eSpark-Backup/zion-holmes-portable-charger/Deliverables/Portable Charger v1.0/Renderings/2D_Top_View.PNG

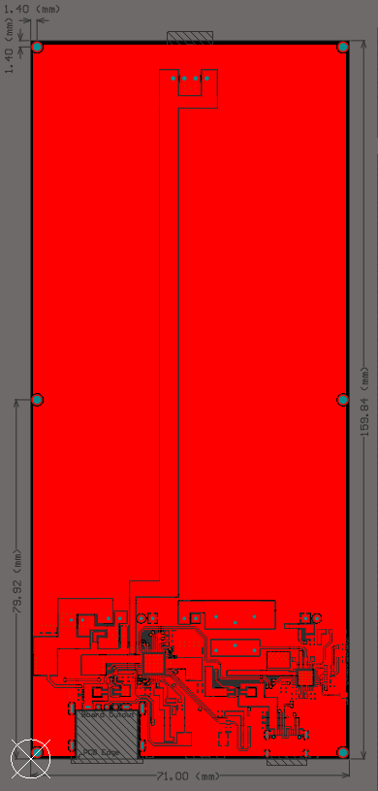
Deliverables/Portable Charger v1.0/Renderings/2D_Top_View.PNG
