eSpark-Backup/zion-holmes-portable-charger/Deliverables/Portable Charger v1.0/Renderings/3D_Bottom_View.PNG

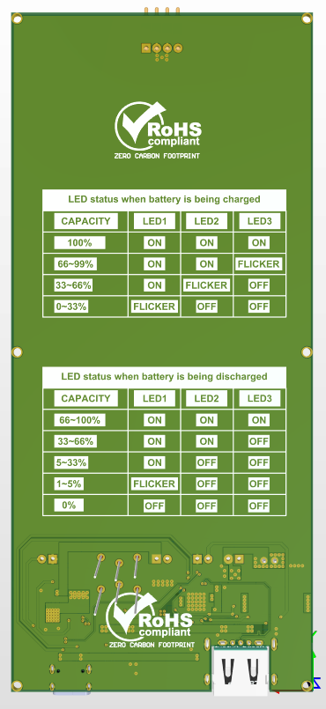
Deliverables/Portable Charger v1.0/Renderings/3D_Bottom_View.PNG
