eSpark-Backup/zion-holmes-portable-charger/Deliverables/Portable Charger v1.0/Renderings/3D_Isometric_View.png

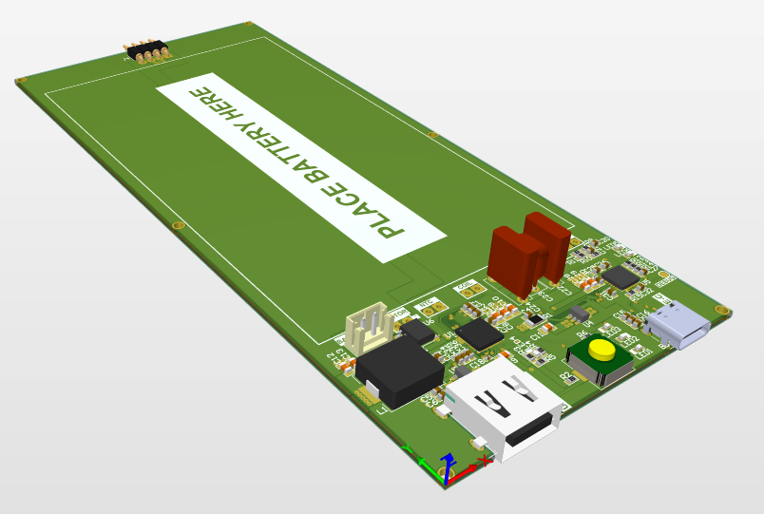
Deliverables/Portable Charger v1.0/Renderings/3D_Isometric_View.png
