eSpark-Backup/zion-holmes-portable-charger/Deliverables/Portable Charger v1.0/Supporting Files/Portable-Charger-v1.0_3D.step

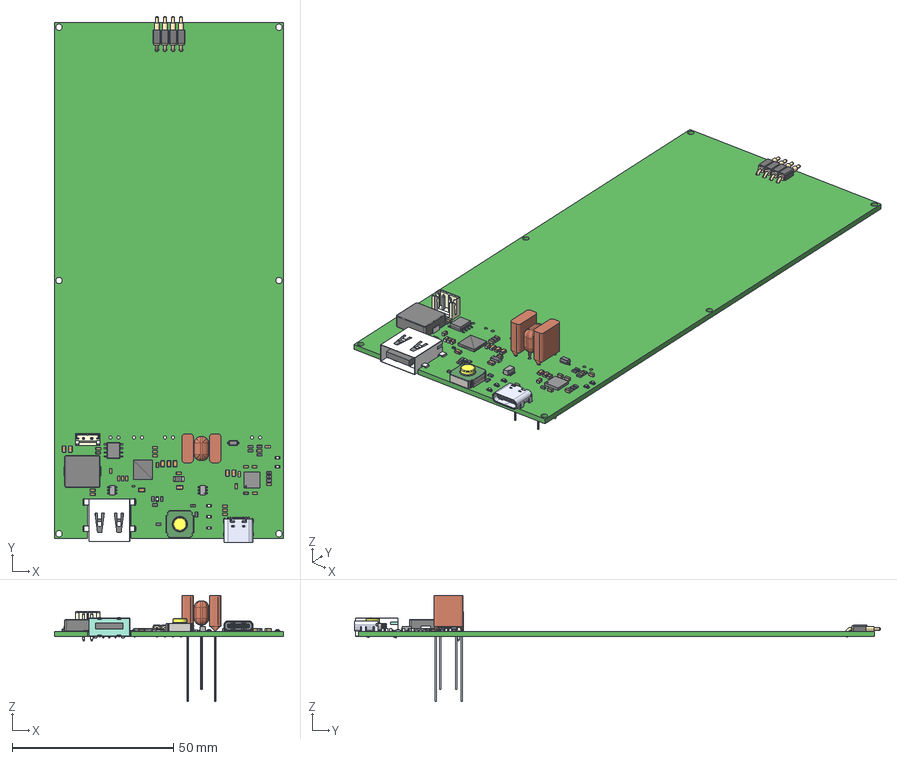
[picture p7: CAD file, 2023-05-12]
Deliverables/Portable Charger v1.0/Supporting Files/Portable-Charger-v1.0_3D.step
71.0 x 163.2 x 33.0 mm
User_Library-CAPC1608X09 x 23
AP64501SP-13
User_Library-RESC1608X05N x 15
User_Library-QFN-32-5x5_-_EQ
21-0058I_MXM x 2
U224-051N-3GRA035
QFN-48
skstace010
User_Library-CR3216-1206
User_Library-LED_SMD0603 x 6
yspi1040-2r2m
Pogo_Spring_4_Pin
TYPE-C-31-M-12
User_Library-B2B-EH-A
1N5819HW-7-F--3DModel-STEP-56544
User_Library-0805_SMD_Capacitor x 9
MPP254J100V82CB0035 x 2
PE154J2A0502
User_Library-Capacitor_0402
