eSpark-Backup/zion-holmes-portable-charger/Deliverables/Portable Charger v1.0/Supporting Files/Portable-Charger-v1.0.DXF

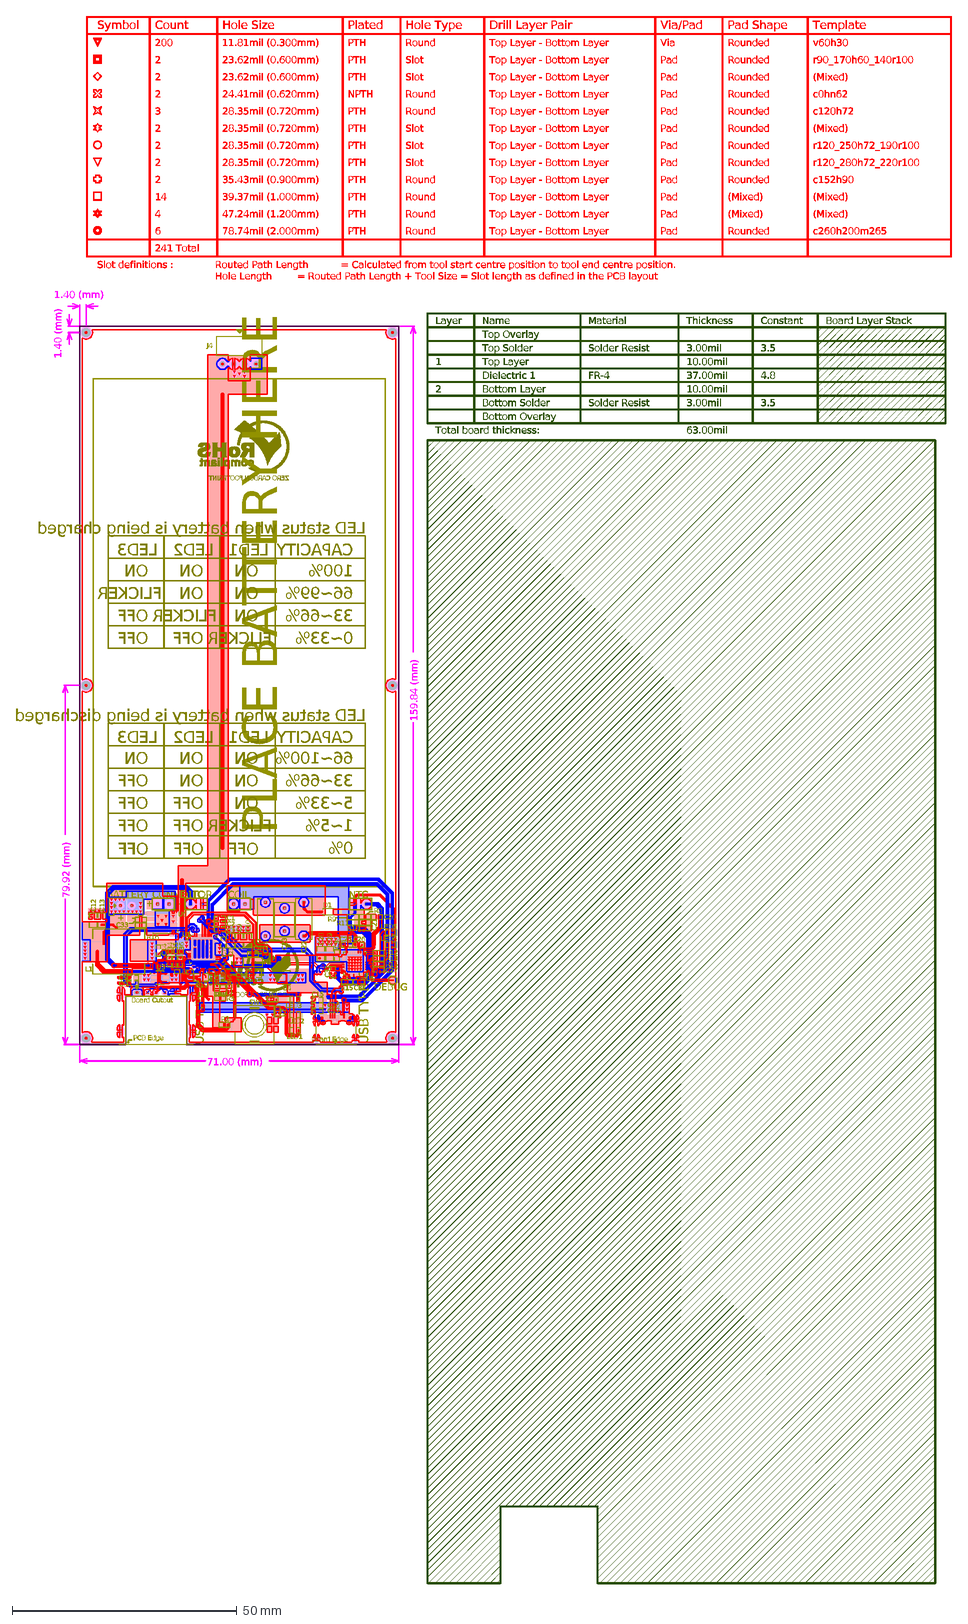
[picture p8: CAD file, 2023-05-12]
Deliverables/Portable Charger v1.0/Supporting Files/Portable-Charger-v1.0.DXF
-
+
USB TYPE-C
DEBUG
PLACE BATTERY HERE
NTC
COIL
USB TYPE-A
BATTERY CONNECTOR
Template
v60h30
r90_170h60_140r100
(Mixed)
c0hn62
c120h72
r120_250h72_190r100
r120_280h72_220r100
c152h90
c260h200m265
Pad Shape
Rounded
Via/Pad
Via
Pad
Drill Layer Pair
Top Layer - Bottom Layer
Hole Type
Round
Slot
Plated
PTH
NPTH
Hole Size
11.81mil (0.300mm)
23.62mil (0.600mm)
24.41mil (0.620mm)
28.35mil (0.720mm)
35.43mil (0.900mm)
39.37mil (1.000mm)
47.24mil (1.200mm)
78.74mil (2.000mm)
Count
241 Total
200
2
3
14
4
6
Symbol
= Routed Path Length + Tool Size = Slot length as defined in the PCB layout
Hole Length
= Calculated from tool start centre position to tool end centre position.
Routed Path Length
Slot definitions :
FLICKER
CAPACITY
ON
ZERO CARBON FOOTPRINT
OFF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
