eSpark-Backup/zion-holmes-portable-charger/(list of files, cad)

Other CAD files:
Design Files/Portable-Charger-v1.0/Portable-Charger-v1.0.step
Deliverables/Portable Charger v1.0/Supporting Files/Portable-Charger-v1.0.DWG
