eSpark-Backup/zion-holmes-portable-charger/Deliverables/Portable Charger v1.0/Schematics/Portable-Charger-v1.0.pdf

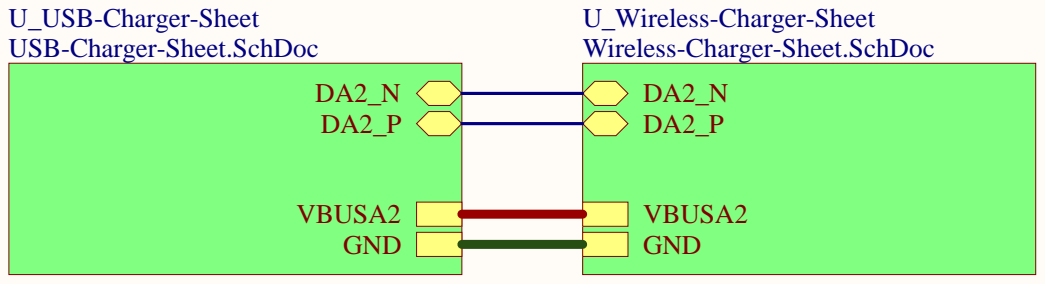
[picture p9: page 1]

U_USB-Charger-Sheet
USB-Charger-Sheet.SchDoc

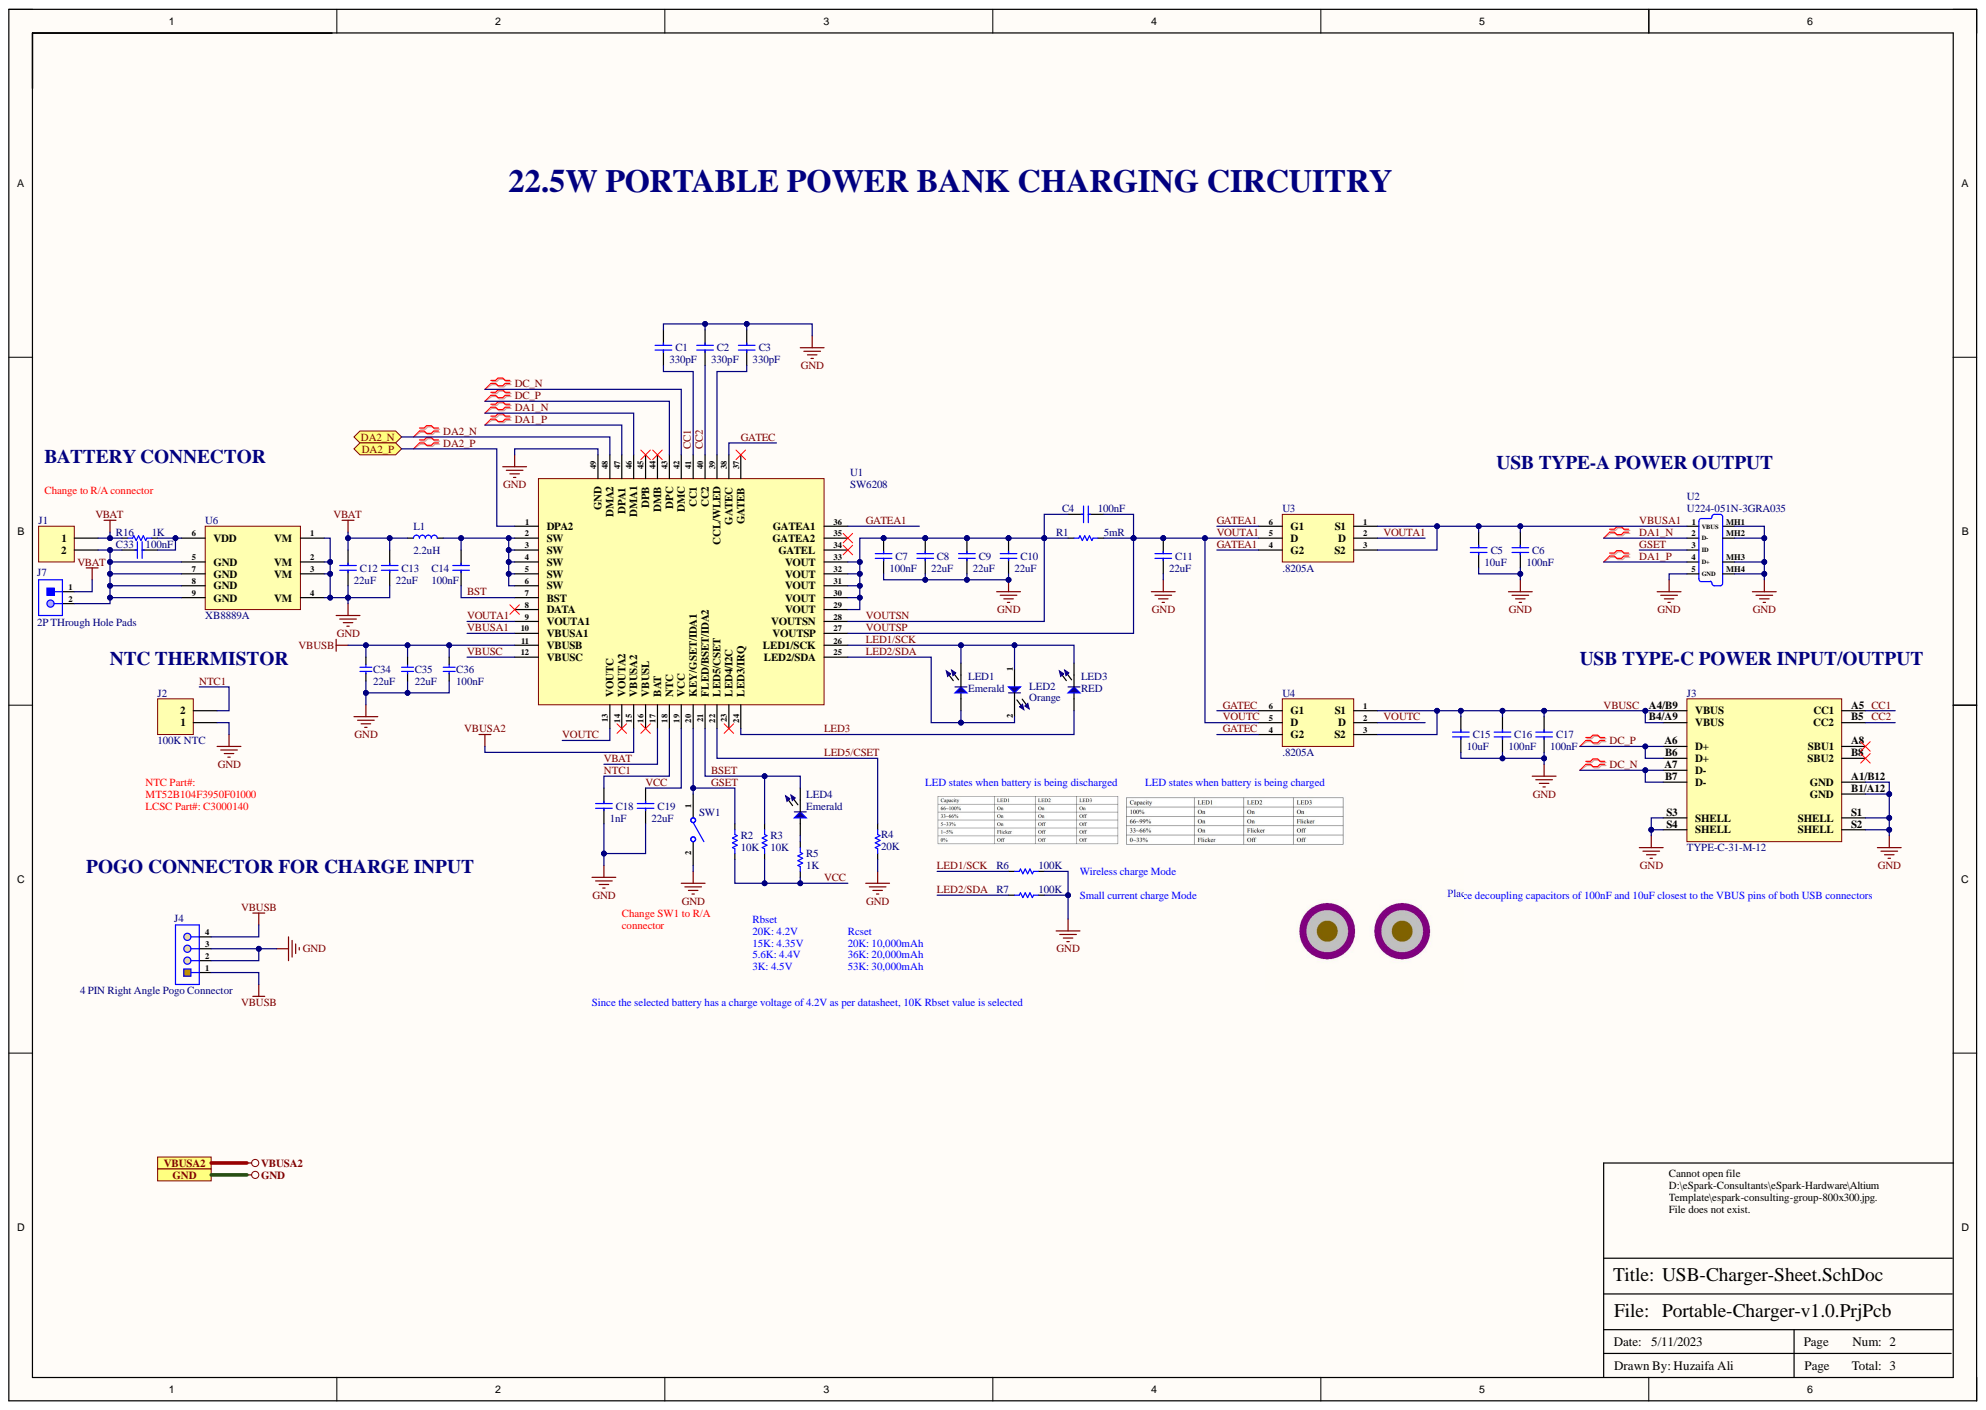
[picture p10: page 2]

22.5W PORTABLE POWER BANK CHARGING CIRCUITRY

ATEB 37 GATEC 38 CCL/WLED 39 CC2 40 CC1 41 DMC 42 DPC 43 DMB 44 DPB 45 DMA1 46 DPA1 47 DMA2 48 GND 49

USB TYPE-A POWER OUTPUT

USB TYPE-C POWER INPUT/OUTPUT

POGO CONNECTOR FOR CHARGE INPUT

Small current charge Mode

Place decoupling capacitors of 100nF and 10uF closest to the VBUS pins of both USB connectors

4 PIN Right Angle Pogo Connector

Since the selected battery has a charge voltage of 4.2V as per datasheet, 10K Rbset value is selected

Cannot open file
D:\eSpark-Consultants\eSpark-Hardware\Altium
Template\espark-consulting-group-800x300.jpg.
File does not exist.

USB-Charger-Sheet.SchDoc

Date: 5/11/2023 | Page Num: 2

Drawn By: Huzaifa Ali | Page Total:

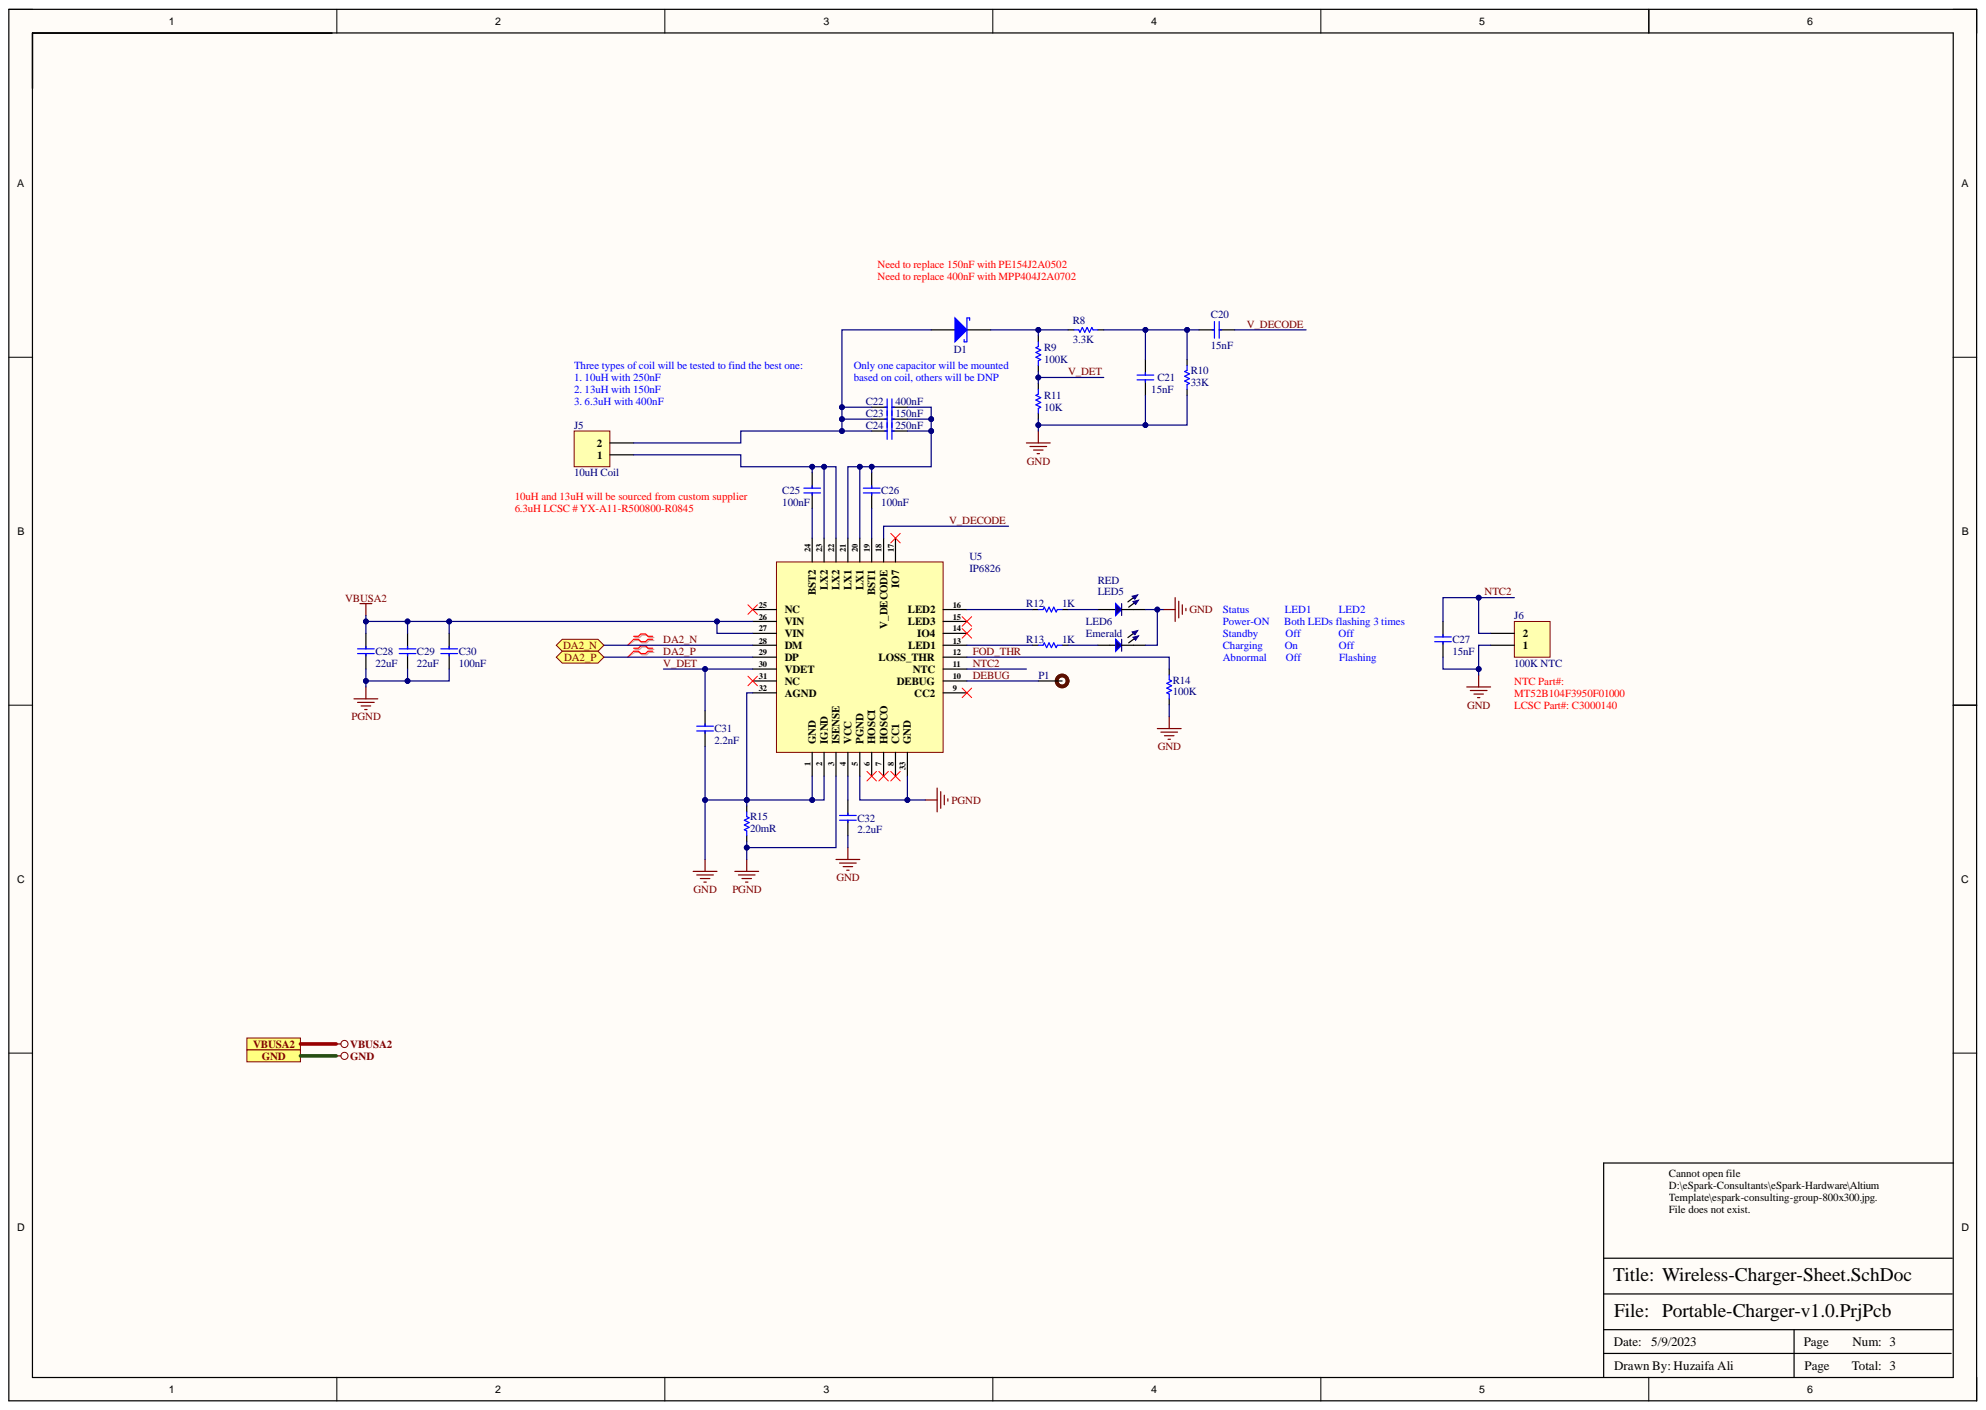
[picture p11: page 3]

Need to replace 150nF with PE154J2A0502
Need to replace 400nF with MPP404J2A0702

Three types of coil will be tested to find the best one:
1. 10uH with 250nF
2. 13uH with 150nF
3. 6.3uH with 400nF

Only one capacitor will be mounted
based on coil, others will be DNP

C23 | 150nF
C24 | 250nF

10uH and 13uH will be sourced from custom supplier
6.3uH LCSC # YX-A11-R500800-R0845

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

Wireless-Charger-Sheet.SchDoc

Date: 5/9/2023 | Page Num: 3

Drawn By: Huzaifa Ali | Page Total:
