eSpark-Backup/zion-holmes-portable-charger/Deliverables/Portable Charger v1.0/Schematics/Assembly Drawings.pdf

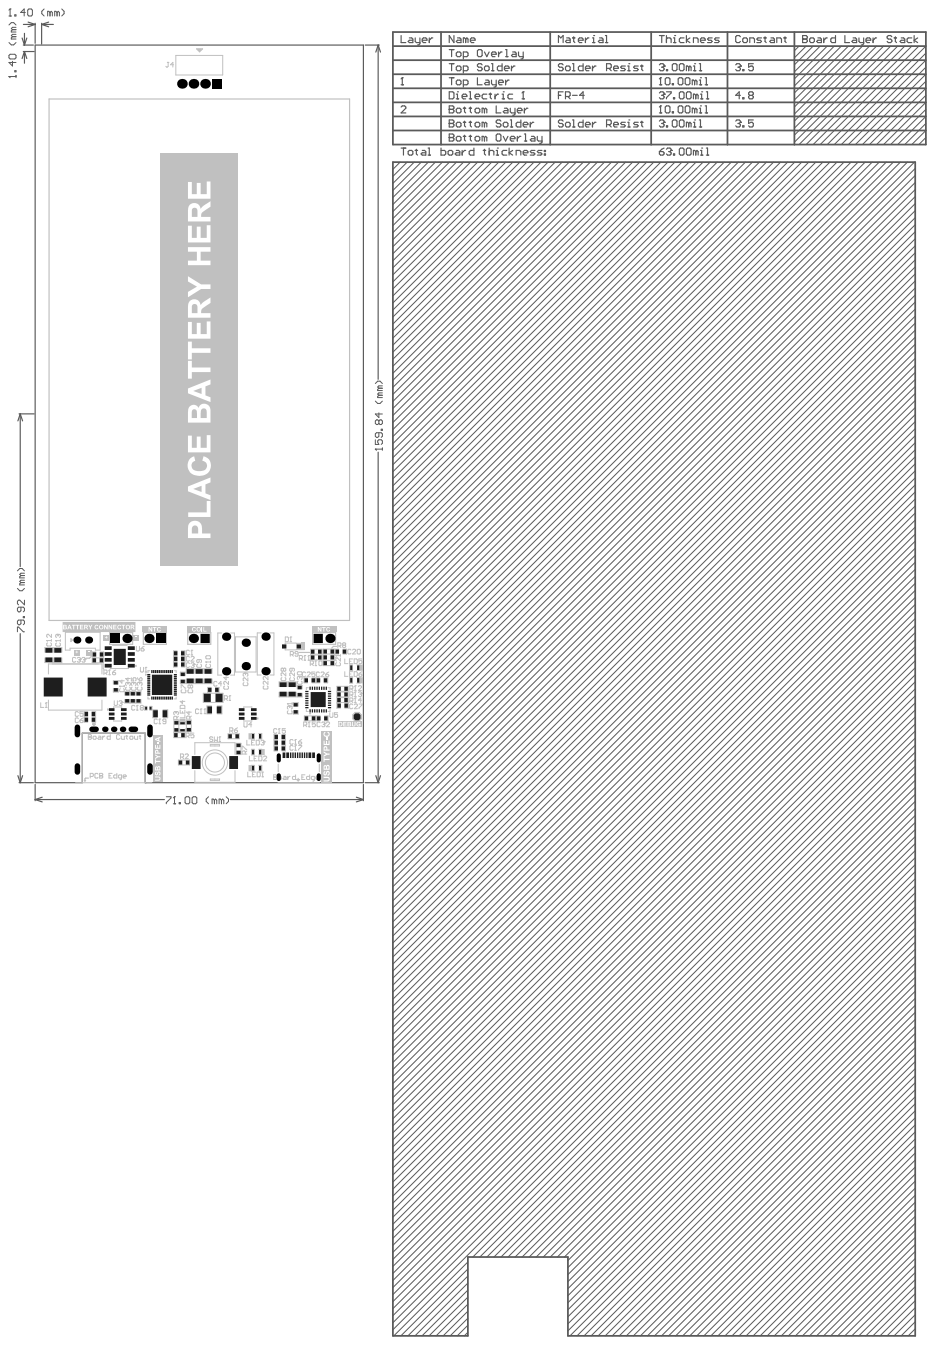
[picture p12: page 1]

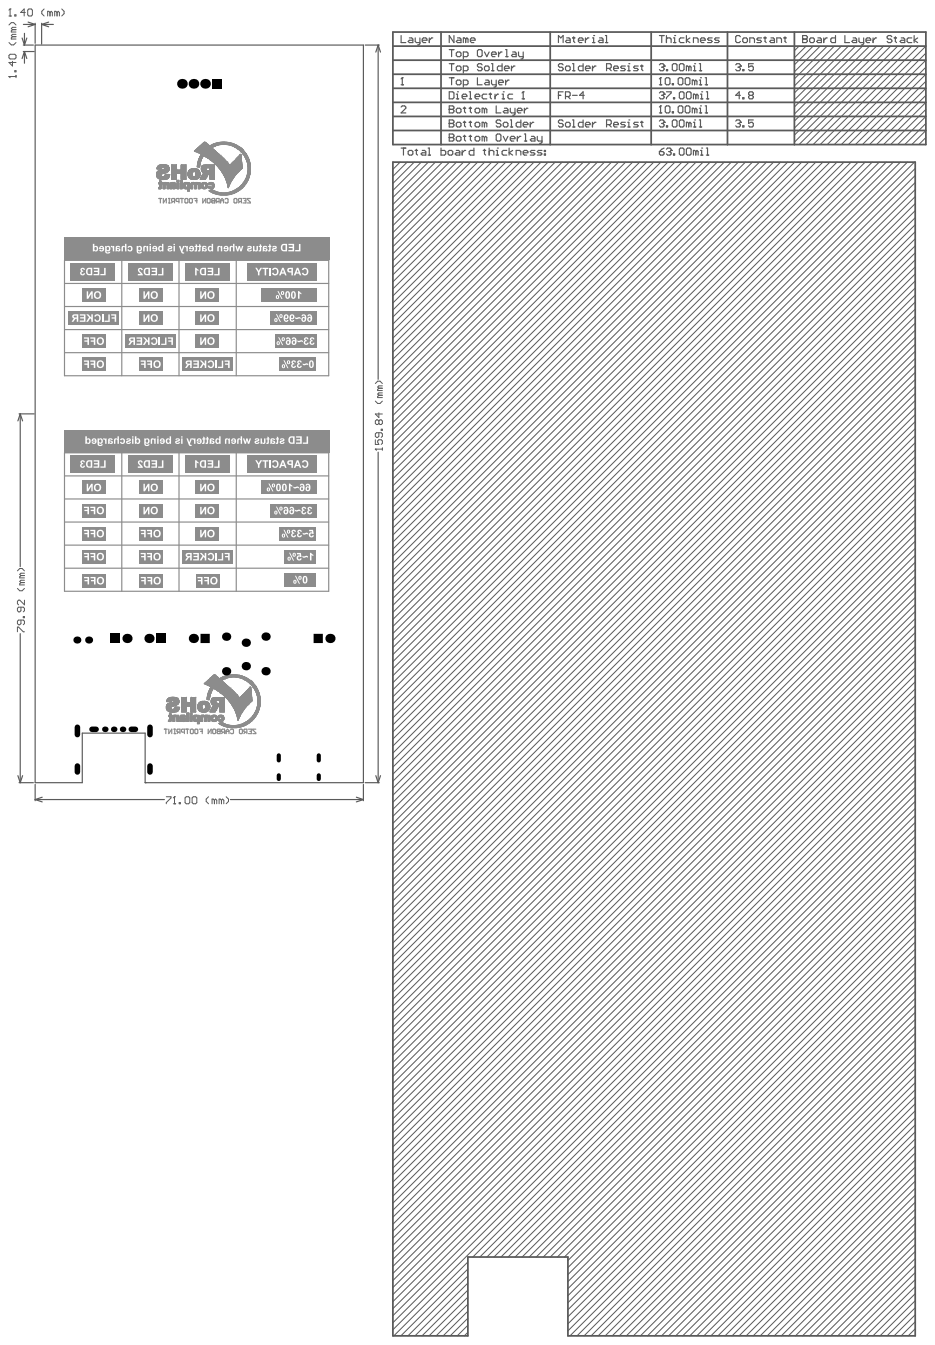
[picture p13: page 2]
