eSpark-Backup/zion-holmes-portable-charger/(list of files, drawings)

Other design files:
Design Files/Portable-Charger-v1.0/Portable-Charger-v1.0.PcbDoc
Design Files/Portable-Charger-v1.0/Portable-Charger-v1.0.PrjPcb
Design Files/Portable-Charger-v1.0/Top-Sheet.SchDoc
Design Files/Portable-Charger-v1.0/USB-Charger-Sheet.SchDoc
Design Files/Portable-Charger-v1.0/Wireless-Charger-Sheet.SchDoc
