eSpark-Backup/zion-holmes-portable-charger/(commit log)

2023-04-10 Wireless Charger Part added
    [Connector-Sheet.SchDoc, Portable-Charger.PrjPcb, USB-Charger-Sheet.SchDoc, Wireless-Charger-Sheet.SchDoc]
2023-04-18 Design version number added
    [Connector-Sheet.SchDoc, Portable-Charger-v1.0.PrjPcb, USB-Charger-Sheet.SchDoc, Wireless-Charger-Sheet.SchDoc]
2023-04-18 SW6208 circuit design (in progress) #1
    [USB-Charger-Sheet.SchDoc, Wireless-Charger-Sheet.SchDoc]
2023-04-19 SW6208 Power bank charger schematic complete #1
    [USB-Charger-Sheet.SchDoc]
2023-04-26 Wireless charger IC schematic complete
    [USB-Charger-Sheet.SchDoc, Wireless-Charger-Sheet.SchDoc]
2023-04-26 notes added #1
    [USB-Charger-Sheet.SchDoc, Wireless-Charger-Sheet.SchDoc]
2023-04-27 Schematic completed #1
    [Connector-Sheet.SchDoc, Portable-Charger-v1.0.PrjPcb, Top-Sheet.SchDoc, USB-Charger-Sheet.SchDoc, Wireless-Charger-Sheet.SchDoc]
2023-04-28 #3 Placement is 90 done as one IC needs to be added
    [Portable-Charger-v1.0.PcbDoc, Portable-Charger-v1.0.PrjPcb, Portable-Charger-v1.0.step, USB-Charger-Sheet.SchDoc]
2023-05-02 XB8889A added. Battery connector pads added
    [USB-Charger-Sheet.SchDoc]
2023-05-02 #3 Changes in PCB after addition of battery protection IC
    [Portable-Charger-v1.0.PcbDoc, Portable-Charger-v1.0.PrjPcb, USB-Charger-Sheet.SchDoc]
2023-05-03 #3 PCB extended to accommodate battery onto it.
    [Portable-Charger-v1.0.PcbDoc, Portable-Charger-v1.0.step, USB-Charger-Sheet.SchDoc]
2023-05-03 #3 Placement Review done. Change in overlay for LED Status indication.
    [Portable-Charger-v1.0.PcbDoc, Top-Sheet.SchDoc, USB-Charger-Sheet.SchDoc, Wireless-Charger-Sheet.SchDoc]
2023-05-04 #3 Routing in progress.
    [Portable-Charger-v1.0.PcbDoc, USB-Charger-Sheet.SchDoc, Wireless-Charger-Sheet.SchDoc]
2023-05-05 #3 3 differential routes remaining
    [Portable-Charger-v1.0.PcbDoc, Portable-Charger-v1.0.PrjPcb, USB-Charger-Sheet.SchDoc]
2023-05-06 #3 Differential Routing done along with length matching of Diff: pairs. No DRC errors
    [Portable-Charger-v1.0.PcbDoc, Portable-Charger-v1.0.PrjPcb]
2023-05-07 #3 Done: Review done with minor adjustments in overlay and routes.
    [Portable-Charger-v1.0.PcbDoc, Portable-Charger-v1.0.PrjPcb, Top-Sheet.SchDoc, USB-Charger-Sheet.SchDoc, Wireless-Charger-Sheet.SchDoc]
2023-05-07 #4 Done. All files updated on Github.
    [Centroid Files.csv, Pick Place for Portable-Charger-v1.0.csv, Portable-Charger-v1.0.DWG, Portable-Charger-v1.0.DXF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]
2023-05-11 J4 changed with suitable connector #1
    [Portable-Charger-v1.0.PcbDoc, Portable-Charger-v1.0.PrjPcb, USB-Charger-Sheet.SchDoc]
2023-05-11 filter caps added on charge line #1
    [USB-Charger-Sheet.SchDoc]
2023-05-11 C34 and C35 changed to 0603 #3
    [USB-Charger-Sheet.SchDoc]
2023-05-11 #3 Design completed after addition of pogo connector decoupling caps and 3 body of pogo.
    [Portable-Charger-v1.0.PcbDoc, Portable-Charger-v1.0.PrjPcb]
2023-05-12 #3 Fresh Deliverables generated with Centroid File
    [Centroid Files.csv, Pick Place for Portable-Charger-v1.0.csv, Portable-Charger-v1.0.DWG, Portable-Charger-v1.0.DXF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]
2023-05-12 #4 Done: Fresh Gerbers, NC Drill and Step files created and updated on Github.
    [Portable-Charger-v1.0.GBL, Portable-Charger-v1.0.GBO, Portable-Charger-v1.0.GBP, Portable-Charger-v1.0.GBS, Portable-Charger-v1.0.GKO, Portable-Charger-v1.0.GTL, Portable-Charger-v1.0.GTO, Portable-Charger-v1.0.GTP]
